FMJ2000/EPR402/README.md

# EPR402
Final year Computer Engineering Project source code repository. Project is to build an autonomous vacuum cleaner.
