FMJ2000/EPR402/body/hendrik.stl

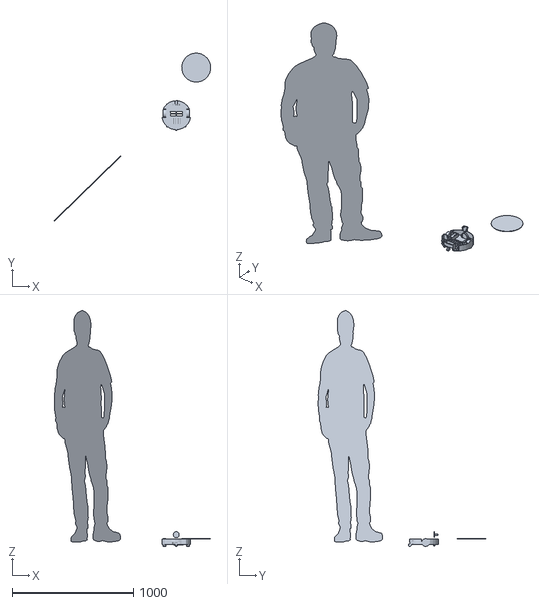
[picture p31: CAD file, 2021-08-24]
body/hendrik.stl
1290.8 x 1384.5 x 1948.0
