FMJ2000/EPR402/Results/Figures/explorer0.png

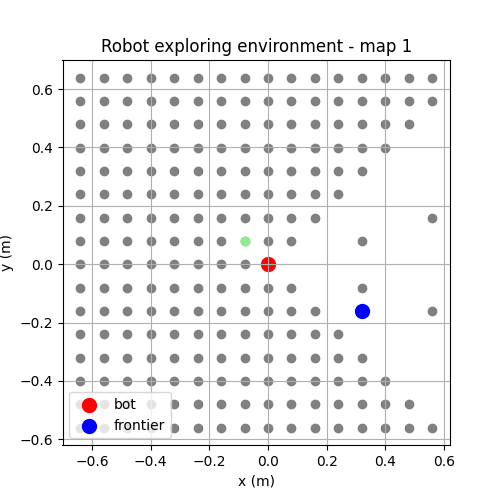
Results/Figures/explorer0.png
