FMJ2000/EPR402/Results/Figures/explorer1.png

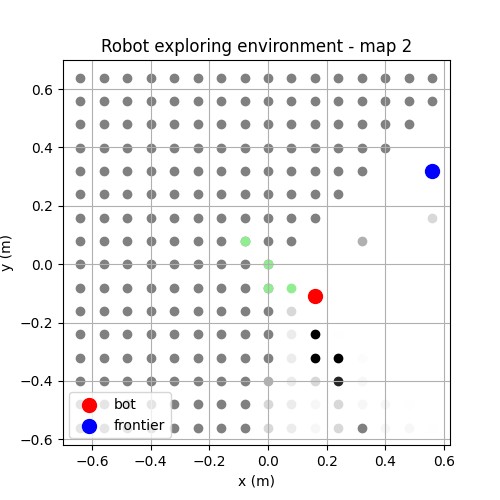
Results/Figures/explorer1.png
