FMJ2000/EPR402/Results/Figures/explorer2.png

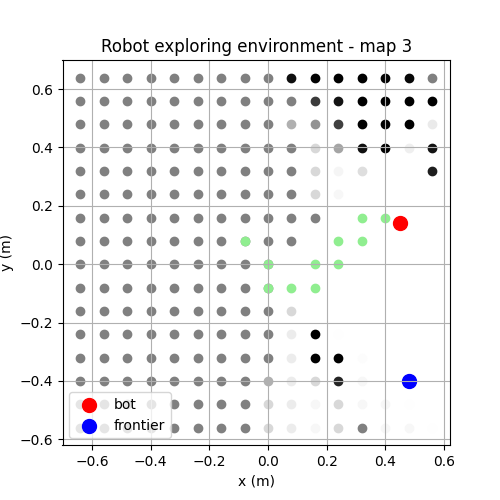
Results/Figures/explorer2.png
