FMJ2000/EPR402/Results/Figures/explorer4.png

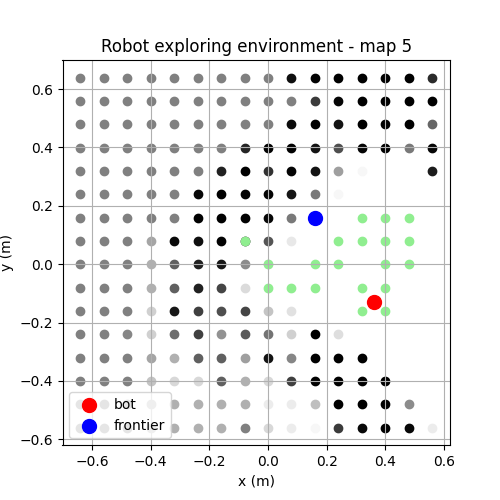
Results/Figures/explorer4.png
