FMJ2000/EPR402/Results/Figures/explorer6.png

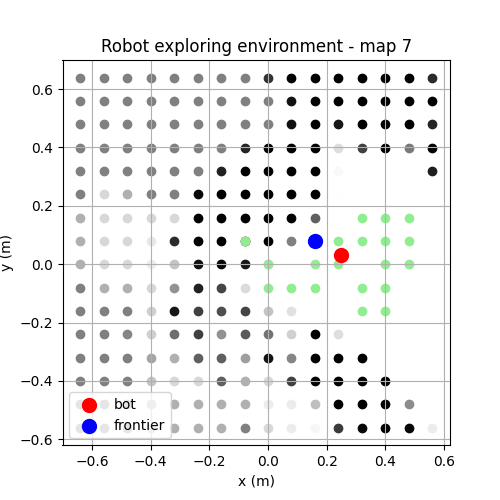
Results/Figures/explorer6.png
