FMJ2000/EPR402/Results/Figures/explorer7.png

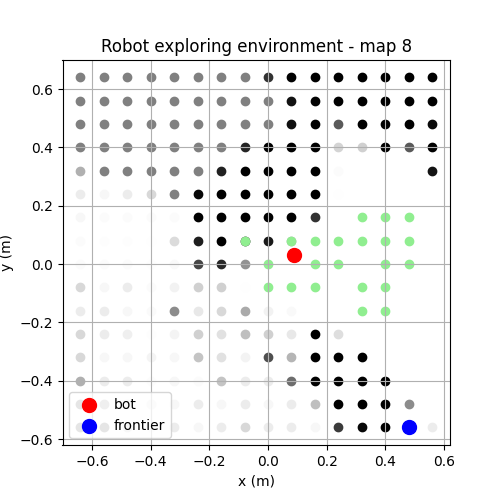
Results/Figures/explorer7.png
