FMJ2000/EPR402/Results/Figures/explorer_full.png

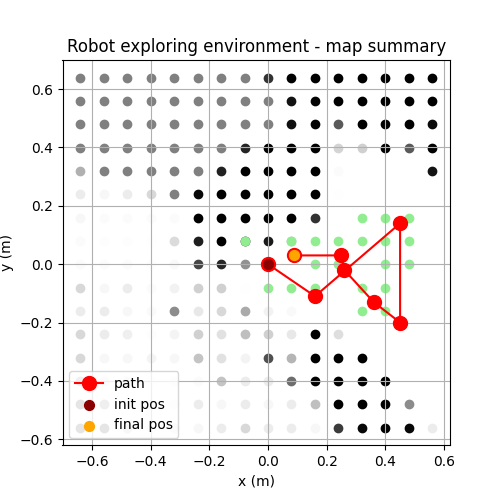
Results/Figures/explorer_full.png
