FMJ2000/EPR402/Results/Figures/planner0.png

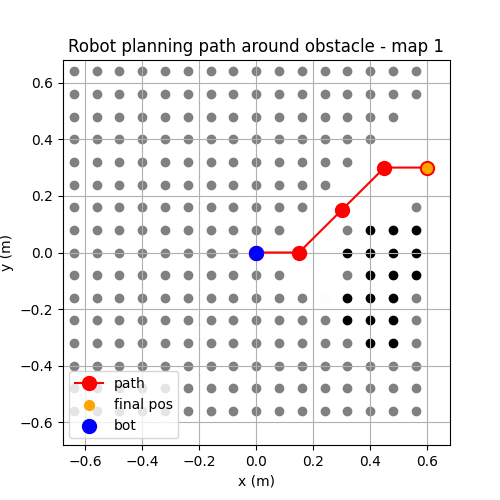
Results/Figures/planner0.png
