FMJ2000/EPR402/Results/Figures/planner3.png

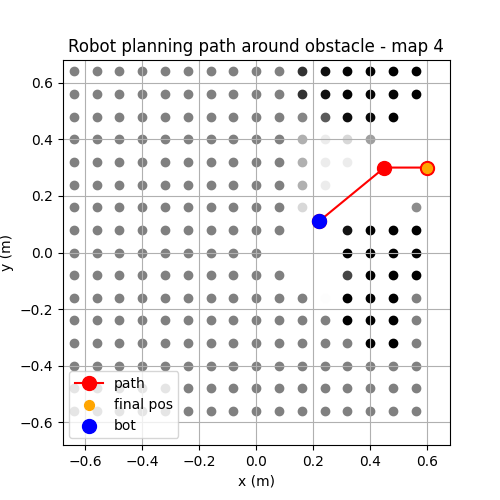
Results/Figures/planner3.png
