FMJ2000/EPR402/Results/Figures/planner5.png

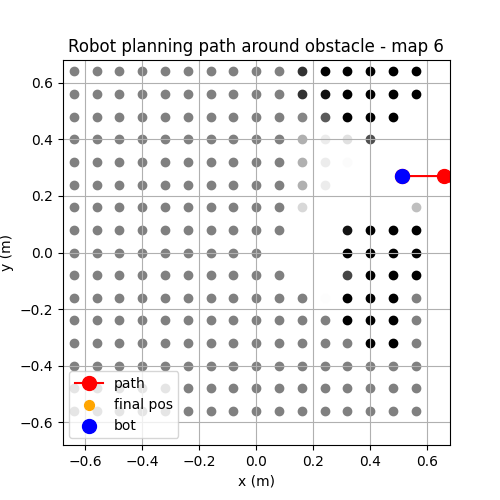
Results/Figures/planner5.png
