FMJ2000/EPR402/Results/Figures/planner8.png

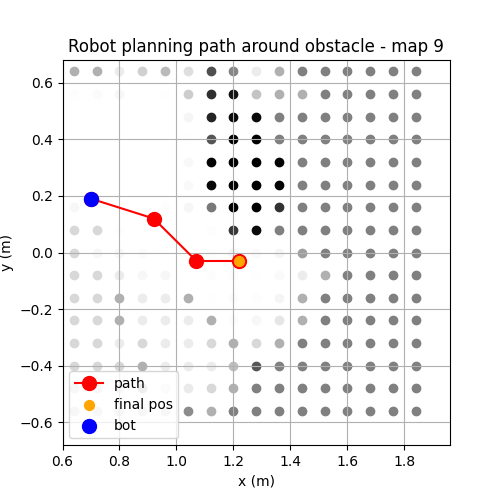
Results/Figures/planner8.png
