FMJ2000/EPR402/Results/Figures/planner9.png

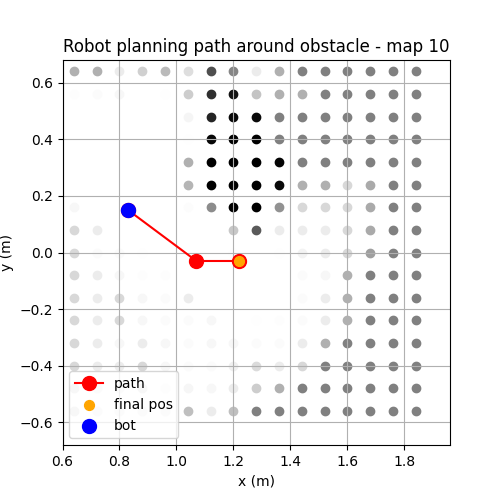
Results/Figures/planner9.png
