FMJ2000/EPR402/Results/Figures/planner10.png

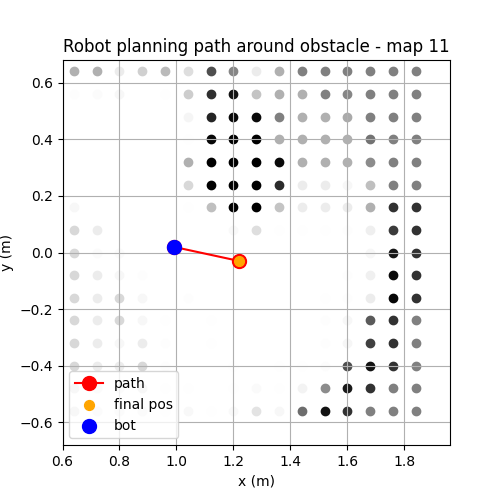
Results/Figures/planner10.png
