FMJ2000/EPR402/Results/Figures/planner11.png

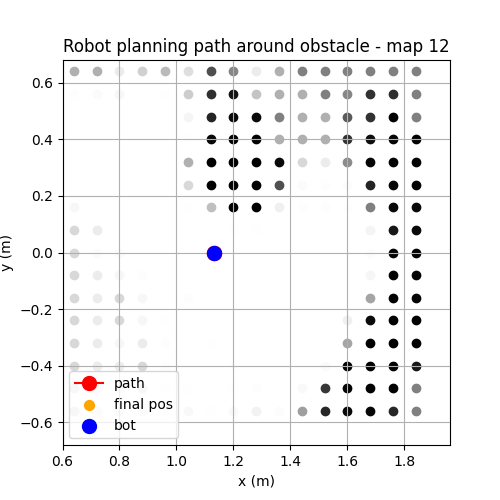
Results/Figures/planner11.png
