FMJ2000/EPR402/Results/Figures/planner_full.png

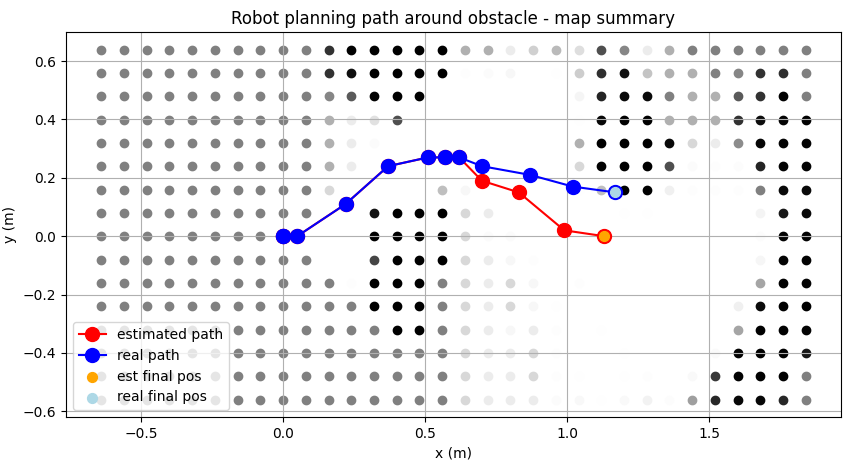
Results/Figures/planner_full.png
