FMJ2000/EPR402/(list of files, drawings)

Other design files:
pcb/hendrik/print.dsn
