FMJ2000/EPR402/pcb/hendrik/hendrik.kicad_pcb

## KiCad design pcb/hendrik/hendrik.kicad_pcb (2021-09-24)

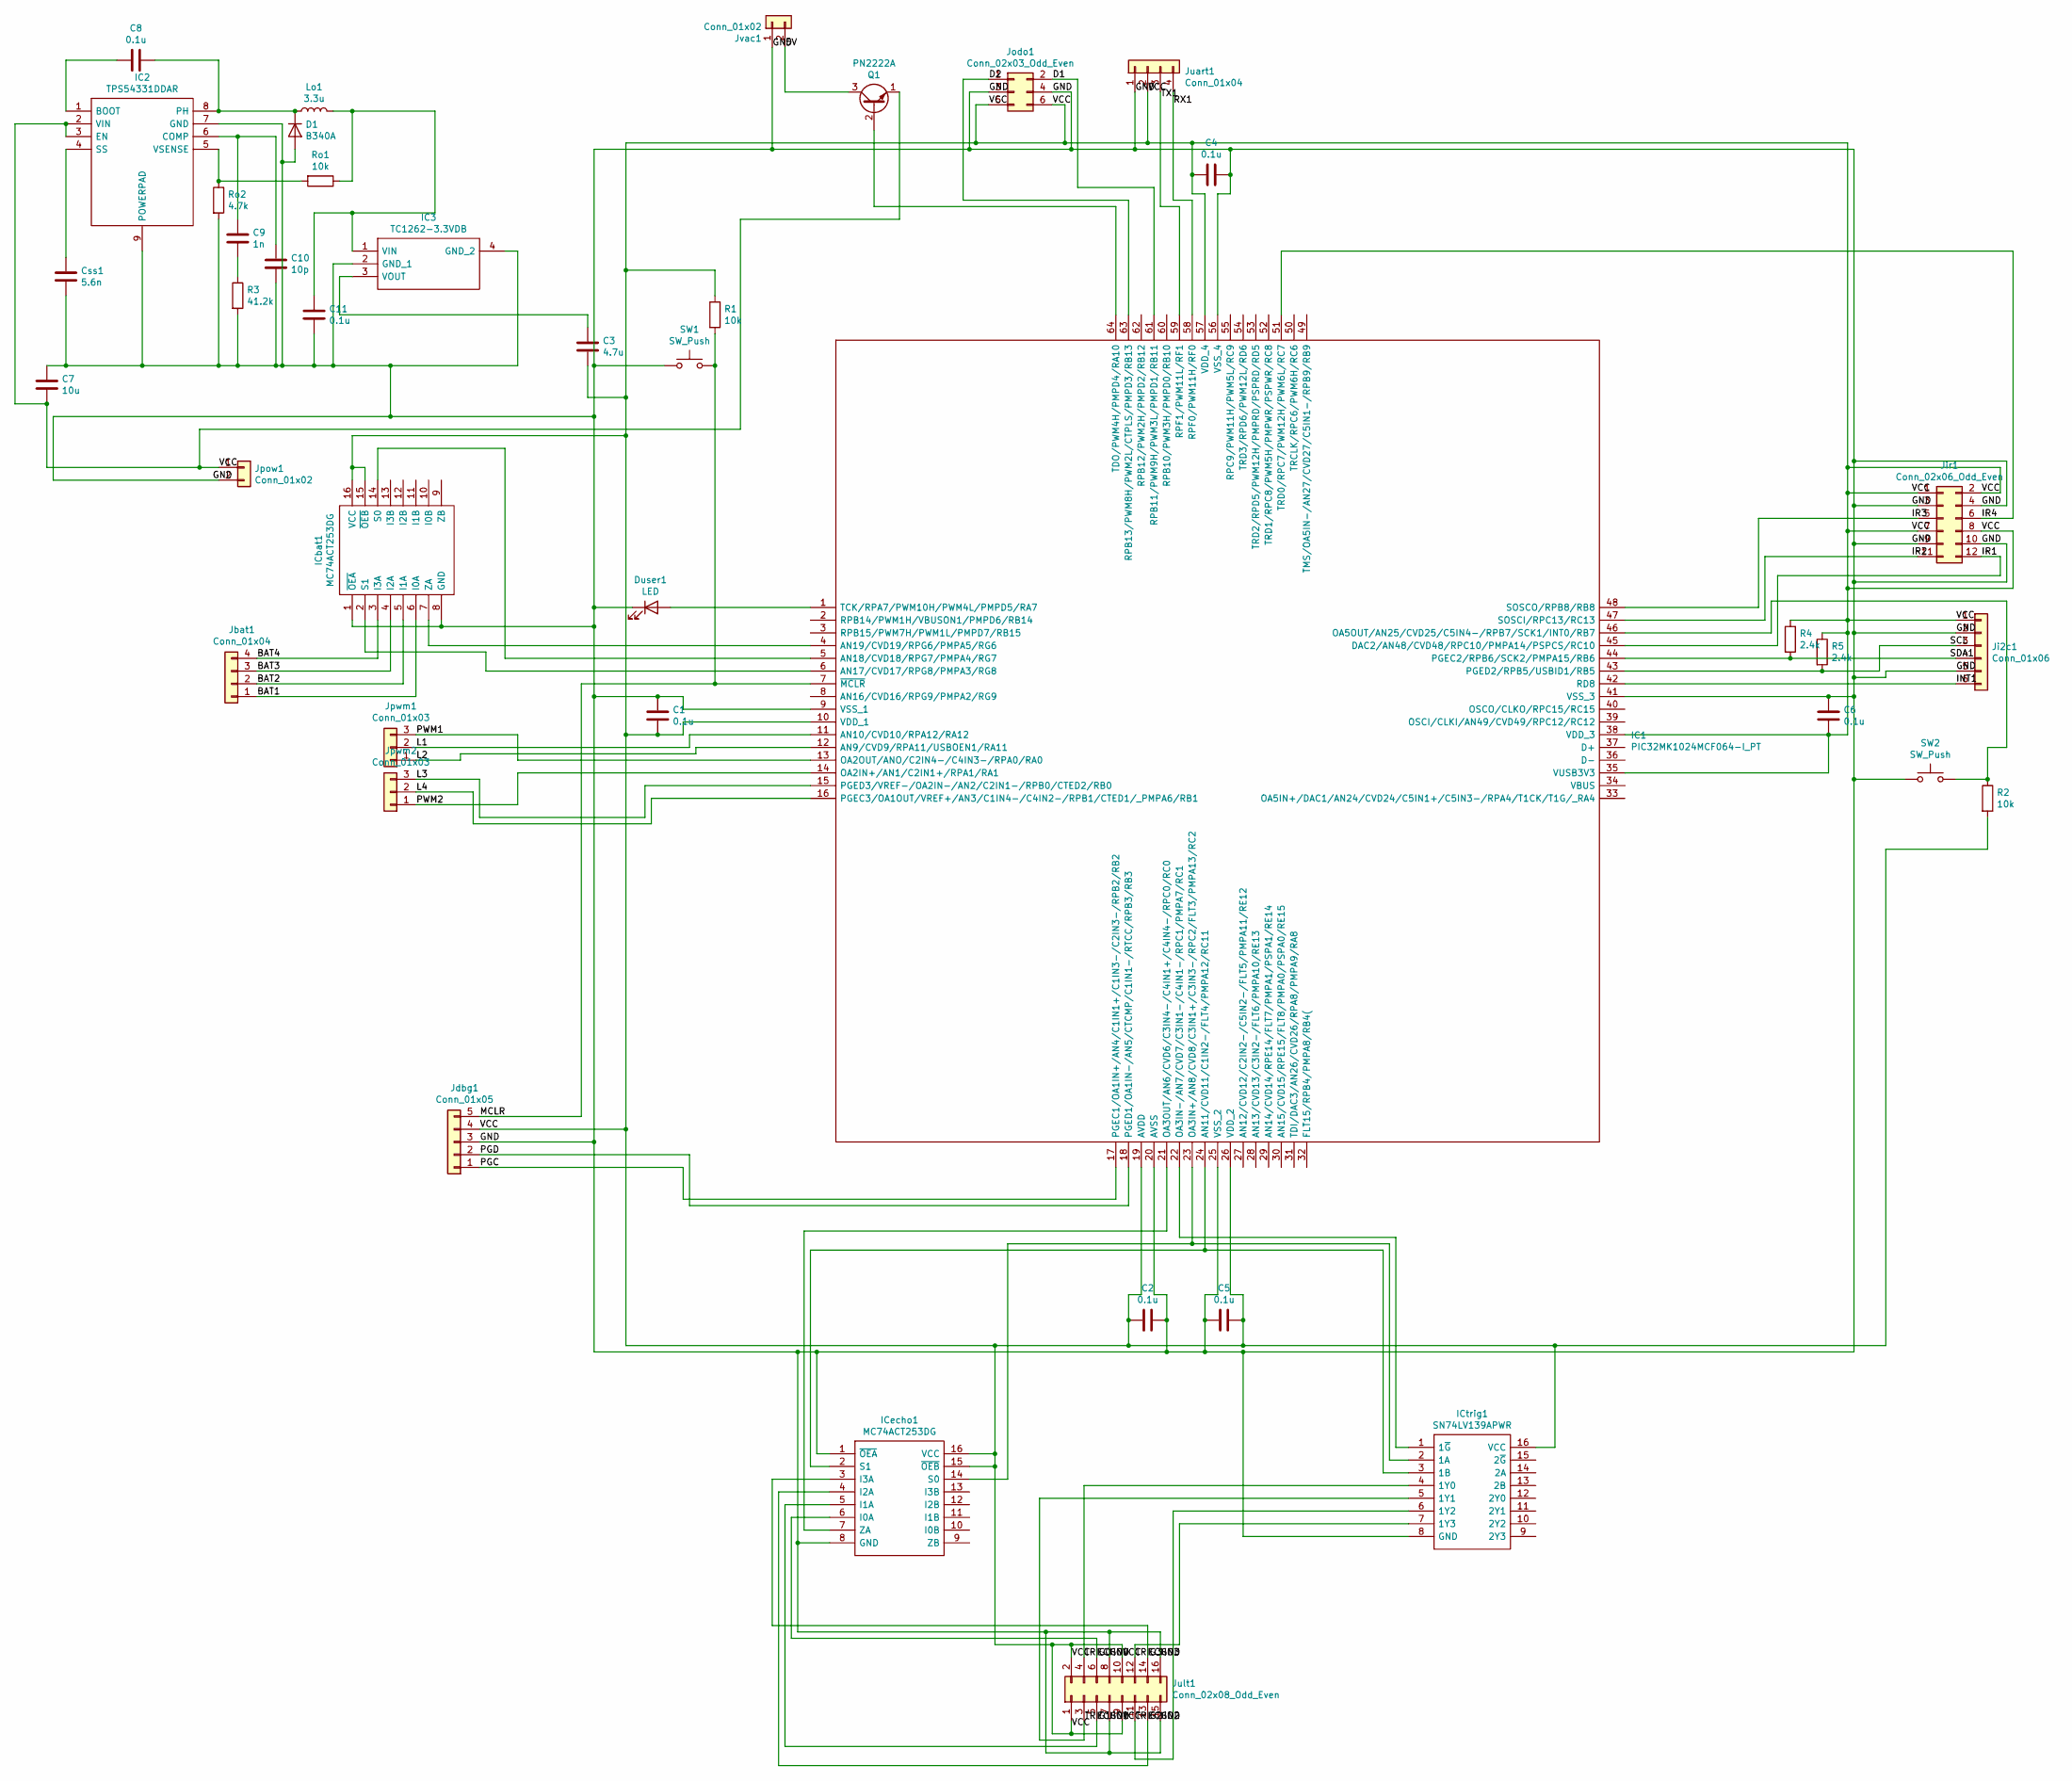
[picture p47: schematic hendrik.sch]

Parts:
C1, C2, C4, C5, C6, C8, C11: 0.1u; C_1206_3216Metric
C3: 4.7u; C_1206_3216Metric
C7: 10u; C_1206_3216Metric
C9: 1n; C_1206_3216Metric
C10: 10p; C_1206_3216Metric
Css1: 5.6n; C_1206_3216Metric
D1: B340A; D_SOD-123
Duser1: LED; LED_1206_3216Metric
IC1: PIC32MK1024MCF064-I_PT; TQFP-64_10x10mm_P0.5mm; Manufacturer_Part_Number PIC32MK1024MCF064-I/PT; Mouser Part Number 579-2MK1024MCF064IPT
IC2: TPS54331DDAR; TI_SO-PowerPAD-8; Manufacturer_Part_Number TPS54331DDAR; Mouser Part Number 595-TPS54331DDAR
IC3: TC1262-3.3VDB; SOT-223; Manufacturer_Part_Number TC1262-3.3VDB; Mouser Part Number 579-TC1262-3.3VDB
ICbat1: MC74ACT253DG; SOIC-16_3.9x9.9mm_P1.27mm; Manufacturer_Part_Number MC74ACT253DG
ICecho1: MC74ACT253DG; SOIC-16_3.9x9.9mm_P1.27mm; Manufacturer_Part_Number MC74ACT253DG
ICtrig1: SN74LV139APWR; TSSOP-16_4.4x5mm_P0.65mm; Manufacturer_Part_Number SN74LV139APWR; Mouser Part Number 595-SN74LV139APWR
Jbat1: Conn_01x04; PinHeader_1x04_P2.54mm_Vertical
Jdbg1: Conn_01x05; PinHeader_1x05_P2.54mm_Vertical
Ji2c1: Conn_01x06; PinHeader_1x06_P2.54mm_Vertical
Jir1: Conn_02x06_Odd_Even; PinHeader_2x06_P2.54mm_Vertical
Jodo1: Conn_02x03_Odd_Even; PinHeader_2x03_P2.54mm_Vertical
Jpow1: Conn_01x02; PinHeader_1x02_P2.54mm_Vertical
Jpwm1, Jpwm2: Conn_01x03; PinHeader_1x03_P2.54mm_Vertical
Juart1: Conn_01x04; PinHeader_1x04_P2.54mm_Vertical
Jult1: Conn_02x08_Odd_Even; PinHeader_2x08_P2.54mm_Vertical
Jvac1: Conn_01x02; PinHeader_1x02_P2.54mm_Vertical
Lo1: 3.3u; L_1210_3225Metric
Q1: PN2222A; TO-92_Inline
R1, R2: 10k; R_1206_3216Metric
R3: 41.2k; R_1206_3216Metric
R4, R5: 2.4k; R_1206_3216Metric
Ro1: 10k; R_1206_3216Metric
Ro2: 4.7k; R_1206_3216Metric
SW1, SW2: SW_Push; SW_PUSH_6mm

Connections:
/5V: Jvac1.2, Q1.3 (C)
/BAT1: ICbat1.6 (I0A), Jbat1.1
/BAT2: ICbat1.5 (I1A), Jbat1.2
/BAT3: ICbat1.4 (I2A), Jbat1.3
/BAT4: ICbat1.3 (I3A), Jbat1.4
/D1: IC1.61 (RPB11/PWM9H/PWM3L/PMPD1/RB11), Jodo1.2
/D2: IC1.63 (RPB13/PWM8H/PWM2L/CTPLS/PMPD3/RB13), Jodo1.1
/ECHO0: ICecho1.6 (I0A), Jult1.6
/ECHO1: ICecho1.5 (I1A), Jult1.5
/ECHO2: ICecho1.4 (I2A), Jult1.13
/ECHO3: ICecho1.3 (I3A), Jult1.14
/GND: C1.1, C2.1, C4.1, C5.2, C6.1, C7.1, C10.2, C11.2, Css1.2, D1.2 (A), Duser1.1 (K), IC1.9 (VSS_1), IC1.20 (AVSS), IC1.25 (VSS_2), IC1.41 (VSS_3), IC1.56 (VSS_4), IC2.7 (GND), IC2.9 (POWERPAD), IC3.2 (GND_1), IC3.4 (GND_2), ICbat1.1 (~OEA), ICbat1.8 (GND), ICecho1.1 (~OEA), ICecho1.8 (GND), ICtrig1.8 (GND), Jdbg1.3, Ji2c1.2, Ji2c1.5, Jir1.3, Jir1.4, Jir1.9, Jir1.10, Jodo1.3, Jodo1.4, Jpow1.2, Juart1.1, Jult1.7, Jult1.8, Jult1.15, Jult1.16, Jvac1.1, R3.2, Ro2.2, SW1.1, SW2.1; also elsewhere on the board
/INT1: IC1.42 (RD8), Ji2c1.6
/IR1: IC1.45 (DAC2/AN48/CVD48/RPC10/PMPA14/PSPCS/RC10), Jir1.12
/IR2: IC1.47 (SOSCI/RPC13/RC13), Jir1.11
/IR3: IC1.48 (SOSCO/RPB8/RB8), Jir1.5
/IR4: IC1.51 (TRD0/RPC7/PWM12H/PWM6L/RC7), Jir1.6
/L1: IC1.11 (AN10/CVD10/RPA12/RA12), Jpwm1.2
/L2: IC1.12 (AN9/CVD9/RPA11/USBOEN1/RA11), Jpwm1.1
/L3: IC1.15 (PGED3/VREF-/OA2IN-/AN2/C2IN1-/RPB0/CTED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), Jpwm2.3
/L4: IC1.16 (PGEC3/OA1OUT/VREF+/AN3/C1IN4-/C4IN2-/RP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), Jpwm2.2
/MCLR: IC1.7 (~MCLR), Jdbg1.5, R1.2, SW1.2; also elsewhere on the board
/PGC: IC1.17 (PGEC1/OA1IN+/AN4/C1IN1+/C1IN3-/C2IN3-/R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), Jdbg1.1
/PGD: IC1.18 (PGED1/OA1IN-/AN5/CTCMP/C1IN1-/RTCC/RPB3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), Jdbg1.2
/PWM1: IC1.13 (OA2OUT/ANO/C2IN4-/C4IN3-/RPA0/RA0), Jpwm1.3
/PWM2: IC1.14 (OA2IN+/AN1/C2IN1+/RPA1/RA1), Jpwm2.1
/RX1: IC1.58 (RPF0/PWM11H/RF0), Juart1.4
/SCL: IC1.43 (PGED2/RPB5/USBID1/RB5), Ji2c1.3, R5.2
/SDA1: IC1.44 (PGEC2/RPB6/SCK2/PMPA15/RB6), Ji2c1.4, R4.2
/TRIG0: ICtrig1.4 (1Y0), Jult1.4
/TRIG1: ICtrig1.5 (1Y1), Jult1.3
/TRIG2: ICtrig1.6 (1Y2), Jult1.11
/TRIG3: ICtrig1.7 (1Y3), Jult1.12
/TX1: IC1.59 (RPF1/PWM11L/RF1), Juart1.3
/VCC: C1.2, C2.2, C3.2, C4.2, C5.1, C6.2, C7.2, IC1.10 (VDD_1), IC1.19 (AVDD), IC1.26 (VDD_2), IC1.35 (VUSB3V3), IC1.38 (VDD_3), IC1.57 (VDD_4), IC2.2 (VIN), IC2.3 (EN), ICbat1.15 (~OEB), ICbat1.16 (VCC), ICecho1.15 (~OEB), ICecho1.16 (VCC), ICtrig1.16 (VCC), Jdbg1.4, Ji2c1.1, Jir1.1, Jir1.2, Jir1.7, Jir1.8, Jodo1.5, Jodo1.6, Jpow1.1, Juart1.2, Jult1.1, Jult1.2, Jult1.9, Jult1.10, Q1.1 (E), R1.1, R2.2, R4.1, R5.1
unnamed: C3.1, IC3.3 (VOUT)
unnamed: C8.1, D1.1 (K), IC2.8 (PH), Lo1.1
unnamed: C8.2, IC2.1 (BOOT)
unnamed: C9.2, R3.1
unnamed: C9.1, C10.1, IC2.6 (COMP)
unnamed: C11.1, IC3.1 (VIN), Lo1.2, Ro1.1
unnamed: Css1.1, IC2.4 (SS)
unnamed 42: Duser1.2 (A), IC1.1 (TCK/RPA7/PWM10H/PWM4L/PMPD5/RA7); also elsewhere on the board
unnamed: IC1.4 (AN19/CVD19/RPG6/PMPA5/RG6), ICbat1.7 (ZA)
unnamed: IC1.5 (AN18/CVD18/RPG7/PMPA4/RG7), ICbat1.14 (S0)
unnamed: IC1.6 (AN17/CVD17/RPG8/PMPA3/RG8), ICbat1.2 (S1)
unnamed: IC1.21 (OA3OUT/AN6/CVD6/C3IN4-/C4IN1+/C4IN4-/RP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), ICecho1.7 (ZA)
unnamed: IC1.22 (OA3IN-/AN7/CVD7/C3IN1-/C4IN1-/RPC1/PMPA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), ICtrig1.1 (1~G)
unnamed: IC1.23 (OA3IN+/AN8/CVD8/C3IN1+/C3IN3-/RPC2/FLT3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), ICecho1.14 (S0), ICtrig1.2 (1A)
unnamed: IC1.24 (AN11/CVD11/C1IN2-/FLT4/PMPA12/RC11), ICecho1.2 (S1), ICtrig1.3 (1B)
unnamed 65: IC1.46 (OA5OUT/AN25/CVD25/C5IN4-/RPB7/SCK1/INT0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), R2.1, SW2.2; also elsewhere on the board
unnamed: IC1.64 (TDO/PWM4H/PMPD4/RA10), Q1.2 (B)
unnamed: IC2.5 (VSENSE), Ro1.2, Ro2.1

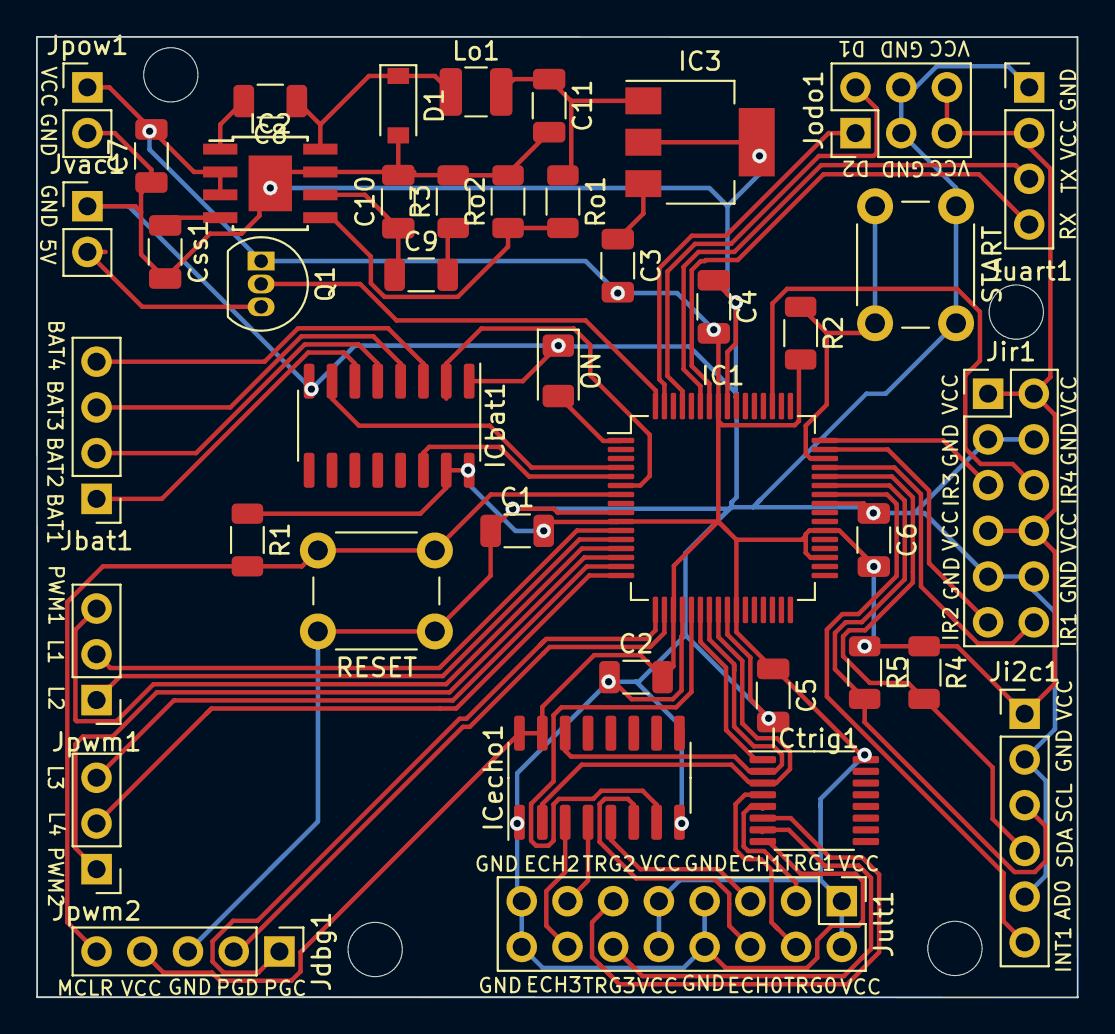
[picture p48: board hendrik.kicad_pcb from above]

Board: 2 copper layers, 57.8 x 53.4 mm, 42 parts (0 on the bottom side), 53 nets.

Other parts of the board:
ON: LED; LED_1206_3216Metric
RESET: SW_Push; SW_PUSH_6mm
START: SW_Push; SW_PUSH_6mm

Their connections:
/GND: ON.1, RESET.1, START.1; also elsewhere on the board
/MCLR: RESET.2; also elsewhere on the board
unnamed 42: ON.2; also elsewhere on the board
unnamed 65: START.2; also elsewhere on the board
