FMJ2000/EPR402/ultrasonic/hcsr04_tut/hcsr04_tut.ino

#define echoPin1 2
#define trigPin1 3
#define echoPin2 4
#define trigPin2 5

long duration1, duration2;
float distance1, distance2;

void setup() {
  pinMode(trigPin1, OUTPUT);
  pinMode(trigPin2, OUTPUT);
  pinMode(echoPin1, INPUT);
  pinMode(echoPin2, INPUT);
  Serial.begin(9600);
  Serial.println("Ultrasonic Sensor HC-SR04 Test");
  Serial.println("with Arduino UNO");
}

void loop() {
  // sensor 1
  digitalWrite(trigPin1, LOW);
  delayMicroseconds(2);
  digitalWrite(trigPin1,HIGH);
  delayMicroseconds(10);
  digitalWrite(trigPin1, LOW);
  duration1 = pulseIn(echoPin1, HIGH);
  distance1 = duration1 * 0.034 / 2;

  // sensor 2
  digitalWrite(trigPin2, LOW);
  delayMicroseconds(2);
  digitalWrite(trigPin2,HIGH);
  delayMicroseconds(10);
  digitalWrite(trigPin2, LOW);
  duration2 = pulseIn(echoPin2, HIGH);
  distance2 = duration2 * 0.034 / 2;
  
  Serial.print("distance 1: ");
  Serial.print(distance1);
  Serial.print(" cm\tdistance 2: ");
  Serial.print(distance2);
  Serial.println(" cm");
  delay(500);
}
