FMJ2000/EPR402/mplab/Master.X/oled.c

/*
 * @file OLED.c
 * @author xpress_embedo
 * @date 2 Feb, 2020
 * 
 * @brief This file contains OLED drivers for SSD1306 Controller
 *
 */

#include "oled.h"

// Constant Fonts
const uint8_t SMALL_FONTS[] =
{
0x06, 0x08, 0x20, 0x5f,               // x_size, y_size, offset, number of char
0x00, 0x00, 0x00, 0x00, 0x00, 0x00,   // sp
0x00, 0x00, 0x00, 0x2f, 0x00, 0x00,   // !
0x00, 0x00, 0x07, 0x00, 0x07, 0x00,   // "
0x00, 0x14, 0x7f, 0x14, 0x7f, 0x14,   // #
0x00, 0x24, 0x2a, 0x7f, 0x2a, 0x12,   // $
0x00, 0x23, 0x13, 0x08, 0x64, 0x62,   // %
0x00, 0x36, 0x49, 0x55, 0x22, 0x50,   // &
0x00, 0x00, 0x05, 0x03, 0x00, 0x00,   // '
0x00, 0x00, 0x1c, 0x22, 0x41, 0x00,   // (
0x00, 0x00, 0x41, 0x22, 0x1c, 0x00,   // )
0x00, 0x14, 0x08, 0x3E, 0x08, 0x14,   // *
0x00, 0x08, 0x08, 0x3E, 0x08, 0x08,   // +
0x00, 0x00, 0x00, 0xA0, 0x60, 0x00,   // ,
0x00, 0x08, 0x08, 0x08, 0x08, 0x08,   // -
0x00, 0x00, 0x60, 0x60, 0x00, 0x00,   // .
0x00, 0x20, 0x10, 0x08, 0x04, 0x02,   // /

0x00, 0x3E, 0x51, 0x49, 0x45, 0x3E,   // 0
0x00, 0x00, 0x42, 0x7F, 0x40, 0x00,   // 1
0x00, 0x42, 0x61, 0x51, 0x49, 0x46,   // 2
0x00, 0x21, 0x41, 0x45, 0x4B, 0x31,   // 3
0x00, 0x18, 0x14, 0x12, 0x7F, 0x10,   // 4
0x00, 0x27, 0x45, 0x45, 0x45, 0x39,   // 5
0x00, 0x3C, 0x4A, 0x49, 0x49, 0x30,   // 6
0x00, 0x01, 0x71, 0x09, 0x05, 0x03,   // 7
0x00, 0x36, 0x49, 0x49, 0x49, 0x36,   // 8
0x00, 0x06, 0x49, 0x49, 0x29, 0x1E,   // 9
0x00, 0x00, 0x36, 0x36, 0x00, 0x00,   // :
0x00, 0x00, 0x56, 0x36, 0x00, 0x00,   // ;
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
0x01,0x01,0x01,0x01,0x00,0x00,0x00,0x00,0x01,0x01,0x01,0x01,0x01,0x00,0x00,0x00,
0x00,0x00,0x01,0x01,0x01,0x00,0x00,0x00,0x00,0x00,0x00,0x00,0x18,0x1D,0x1F,0x0F,
0x03,0x00,0x00,0x00,0x00,0x00,0x00,0x00,0x00,0x00,0x00,0x00,0x00,0x00,0x00,0x00,

0x00,0x00,0x00,0x00,0x00,0x00,0x00,0x00,0x00,0x00,0x00,0x00,0x00,0x00,0x00,0x00,
0x00,0x00,0x00,0x00,0x00,0x00,0x00,0x00,0x00,0x00,0x00,0x00,0x00,0x00,0x00,0x00,
0x00,0x00,0x00,0x00,0x00,0x00,0x00,0x00,0x00,0x00,0x00,0x00,0x00,0x00,0x00,0x00,
0x00,0x00,0x00,0x00,0x00,0x00,0x00,0x00,0x00,0x00,0x00,0x00,0x00,0x00,0x00,0x00,
0x00,0x00,0x00,0x00,0x00,0x00,0x00,0x00,0x00,0x00,0x00,0x00,0x00,0x00,0x00,0x00,
0x00,0x00,0x00,0x00,0x00,0x00,0x00,0x00,0x00,0x00,0x00,0x00,0x00,0x00,0x00,0x00,
0x00,0x00,0x00,0x00,0x00,0x00,0x00,0x00,0x00,0x00,0x00,0x00,0x00,0x00,0x00,0x00,
0x00,0x00,0x00,0x00,0x00,0x00,0x00,0x00,0x00,0x00,0x00,0x00,0x00,0x00,0x00,0x00
#endif
#endif
};

/* Local Function Prototypes */
static uint8_t width( void );
static uint8_t height( void );
static void swap_num( uint16_t *a, uint16_t *b );

/* Public Function Definition */

/**
 * @brief OLED_Init
 *
 * Initialize OLED
 */
void OLED_Init( void )
{
    I2C_Write(SSD1306_ADDR, 0x00, SSD1306_DISPLAY_OFF);
    I2C_Write(SSD1306_ADDR, 0x00, SSD1306_SET_DISPLAY_CLOCK_DIV_RATIO);
    I2C_Write(SSD1306_ADDR, 0x00, 0x80);
    I2C_Write(SSD1306_ADDR, 0x00, SSD1306_SET_MULTIPLEX_RATIO);
    I2C_Write(SSD1306_ADDR, 0x00, SSD1306_LCDHEIGHT - 1);
    I2C_Write(SSD1306_ADDR, 0x00, SSD1306_SET_DISPLAY_OFFSET);
    I2C_Write(SSD1306_ADDR, 0x00, 0x00);
    I2C_Write(SSD1306_ADDR, 0x00, SSD1306_SET_START_LINE|0x0);
    I2C_Write(SSD1306_ADDR, 0x00, SSD1306_CHARGE_PUMP);
    I2C_Write(SSD1306_ADDR, 0x00, 0x14);
    I2C_Write(SSD1306_ADDR, 0x00, SSD1306_MEMORY_ADDR_MODE);
    I2C_Write(SSD1306_ADDR, 0x00, 0x00);
    I2C_Write(SSD1306_ADDR, 0x00, SSD1306_SET_SEGMENT_REMAP|0x01);
    I2C_Write(SSD1306_ADDR, 0x00, SSD1306_COM_SCAN_DIR_DEC);
#ifdef SSD1306_128_32
    I2C_Write(SSD1306_ADDR, 0x00, SSD1306_SET_COM_PINS);
    I2C_Write(SSD1306_ADDR, 0x00, 0x02);
    I2C_Write(SSD1306_ADDR, 0x00, SSD1306_SET_CONTRAST_CONTROL);
    I2C_Write(SSD1306_ADDR, 0x00, 0x8F);
#elif defined SSD1306_128_64 
    I2C_Write(SSD1306_ADDR, 0x00, SSD1306_SET_COM_PINS);
    I2C_Write(SSD1306_ADDR, 0x00, 0x12);
    I2C_Write(SSD1306_ADDR, 0x00, SSD1306_SET_CONTRAST_CONTROL);
    I2C_Write(SSD1306_ADDR, 0x00, 0xCF);
#endif
    I2C_Write(SSD1306_ADDR, 0x00, SSD1306_SET_PRECHARGE_PERIOD);
    I2C_Write(SSD1306_ADDR, 0x00, 0xF1);
    I2C_Write(SSD1306_ADDR, 0x00, SSD1306_SET_VCOM_DESELECT);
    I2C_Write(SSD1306_ADDR, 0x00, 0x40);
    I2C_Write(SSD1306_ADDR, 0x00, SSD1306_DISPLAY_ALL_ON_RESUME);
    I2C_Write(SSD1306_ADDR, 0x00, SSD1306_NORMAL_DISPLAY);
    I2C_Write(SSD1306_ADDR, 0x00, SSD1306_DEACTIVATE_SCROLL);
    I2C_Write(SSD1306_ADDR, 0x00, SSD1306_DISPLAY_ON);
    OLED_SetFont(SMALL_FONTS);
    delay(100000);
    OLED_Update();
}

/**
 * @brief OLED_Width
 *
 * Get the OLED Width
 * @return Oled Width
 */
uint8_t OLED_Width( void )
{
  return width();
}

/**
 * @brief OLED_Height
 *
 * Get the OLED Height
 * @return Oled Height
 */
uint8_t OLED_Height( void )
{
  return height();
}

/**
 * @brief OLED_SetFont
 *
 * @param font: Select this font
 */
void OLED_SetFont( const uint8_t *font)
{
  cfont.font = font;
  cfont.x_size = *(font+0);
  cfont.y_size = *(font+1);
  cfont.offset  = *(font+2);
  cfont.numchars  = *(font+3);
  cfont.inverted = FALSE;
}

/**
 * @brief OLED_InvertFont
 *
 * Invert the font
 */
void OLED_InvertFont( uint8_t invert_status )
{
  if( invert_status )
  {
    cfont.inverted = TRUE;
  }
  else
  {
    cfont.inverted = FALSE;
  }
}

/**
 * @brief OLED_Update
 *
 * Update the OLED Buffer on the actual display
 */
void OLED_Update( void )
{
    I2C_Write(SSD1306_ADDR, 0x00, SSD1306_SET_COLUMN_ADDR);
    I2C_Write(SSD1306_ADDR, 0x00, 0x0);
    I2C_Write(SSD1306_ADDR, 0x00, SSD1306_LCDWIDTH-1);
    I2C_Write(SSD1306_ADDR, 0x00, SSD1306_SET_PAGE_ADDR);
    I2C_Write(SSD1306_ADDR, 0x00, 0x0);
 #if SSD1306_LCDHEIGHT == 64
    I2C_Write(SSD1306_ADDR, 0x00, 0x7);// Page end address
  #endif
  #if SSD1306_LCDHEIGHT == 32
    I2C_Write(SSD1306_ADDR, 0x00, 0x3); // Page end address
  #endif
  #if SSD1306_LCDHEIGHT == 16
    I2C_Write(SSD1306_ADDR, 0x00, 0x1); // Page end address
  #endif

    
    I2C_Master_Start();
    I2C_Master_Write(SSD1306_ADDR << 1);
    I2C_Master_Write(0x40);
    for (uint16_t i = 0; i < (SSD1306_LCDWIDTH*SSD1306_LCDHEIGHT/8); i++) I2C_Master_Write(buffer[i]);
    I2C_Master_Stop();
}

/**
 * @brief OLED_SetContrast.
 *
 * Set the OLED display contrast.
 * @param contrast: contrast value
 */
void OLED_SetContrast( uint8_t contrast )
{
    I2C_Write(SSD1306_ADDR, 0x00, SSD1306_SET_CONTRAST_CONTROL);
    I2C_Write(SSD1306_ADDR, 0x00, contrast);
}

/**
 * @brief OLED_DrawPixel.
 *
 * Clear the OLED Buffer.
 */
void OLED_ClearDisplay( void )
{
  memset(buffer, 0, (SSD1306_LCDWIDTH*SSD1306_LCDHEIGHT/8));
}

/**
 * @brief OLED_FillDisplay.
 *
 * Fill the OLED Buffer.
 */
void OLED_FillDisplay( void )
{
  memset(buffer, 0xFF, (SSD1306_LCDWIDTH*SSD1306_LCDHEIGHT/8));
}

/**
 * @brief OLED_InvertDisplay.
 *
 * Invert the Display based on the parameters
 * @param value: If True invert the display
 */
void OLED_InvertDisplay( uint8_t value )
{
  if( value ) I2C_Write(SSD1306_ADDR, 0x00, SSD1306_INVERT_DISPLAY);
  else I2C_Write(SSD1306_ADDR, 0x00, SSD1306_NORMAL_DISPLAY);
}

/**
 * @brief OLED_DrawPixel.
 *
 * Draws a pixel on OLED by using the specified parameters.
 * @param x: x coordinate with valid values: 0..127
 * @param y: y coordinate with valid values: 0..63
 * @param color: color parameter. Valid values: 0 and 1
 */
void OLED_DrawPixel( int16_t x, int16_t y, uint8_t color)
{
  if ( (x < 0) || (x >= width()) || (y < 0) || (y >= height()))
    return;

  switch (color)
  {
    case WHITE:   buffer[x+ (y/8)*SSD1306_LCDWIDTH] |=  (1 << (y&7)); break;
    case BLACK:   buffer[x+ (y/8)*SSD1306_LCDWIDTH] &= ~(1 << (y&7)); break;
    case INVERSE: buffer[x+ (y/8)*SSD1306_LCDWIDTH] ^=  (1 << (y&7)); break;
  }
}

/**
 * @brief Draws a line on OLED.
 *
 * Draws a line on OLED by using the specified parameters.
 * <a href="https://en.wikipedia.org/wiki/Bresenham%27s_line_algorithm">
 * Algorithm Used</a>
 * <a href="http://www.edaboard.com/thread68526.html#post302856"> Program Used
 * </a>
 *
 * @param x_start: x coordinate of start point. Valid values: 0..127
 * @param y_start: x coordinate of start point. Valid values: 0..63
 * @param x_end: x coordinate of end point. Valid values: 0..127
 * @param y_end: y coordinate of end point. Valid values: 0..63
 * @param color: color parameter. Valid values: 0 and 1
 */
void OLED_Line( int16_t x_start, int16_t y_start, int16_t x_end, int16_t y_end, uint8_t color)
{
  int16_t x, y, addx, addy, dx, dy;
  int32_t P;
  int16_t i;
  dx = abs((int16_t)(x_end - x_start));
  dy = abs((int16_t)(y_end - y_start));
  x = x_start;
  y = y_start;

  if(x_start > x_end)
    addx = -1;
  else
    addx = 1;

  if(y_start > y_end)
    addy = -1;
  else
    addy = 1;

  if(dx >= dy)
  {
    P = 2*dy - dx;

    for(i=0; i<=dx; ++i)
    {
      OLED_DrawPixel (x,y,color);
      if(P < 0)
      {
        P += 2*dy;
        x += addx;
      }
      else
      {
        P += 2*dy - 2*dx;
        x += addx;
        y += addy;
      }
    }
  }
  else
  {
    P = 2*dx - dy;
    for(i=0; i<=dy; ++i)
    {
      OLED_DrawPixel (x,y,color);

      if(P < 0)
      {
        P += 2*dx;
        y += addy;
      }
      else
      {
        P += 2*dx - 2*dy;
        x += addx;
        y += addy;
      }
    }
  }
}


/**
 * @brief OLED Vertical Line.
 *
 * Draw vertical line between of length specified by y_start and y_end, and at
 * position specified by x_pos
 *
 * @param y_start: y position to start vertical line. Valid values: 0..63
 * @param y_end: y position to end vertical line. Valid values: 0..63
 * @param x_pos: x position. Valid values: 0..127
 * @param color: color parameter. Valid values: 0 and 1
 */
void OLED_V_Line ( int16_t y_start, int16_t y_end, int16_t x_pos, uint8_t color)
{
  int16_t temp;
  if( y_start > y_end )
  {
    temp = y_start;
    y_start = y_end;
    y_end = temp;
  }

  while( y_start <= y_end )
  {
    OLED_DrawPixel(x_pos, y_start, color);
    y_start++;
  }
}

/**
 * @brief OLED Horizontal Line.
 *
 * Draw horizontal line between of length specified by x_start and x_end, and at
 * position specified by y_pos
 *
 * @param x_start: y position to start horizontal line. Valid values: 0..127
 * @param x_end: y position to end horizontal line. Valid values: 0..127
 * @param y_pos: x position. Valid values: 0..63
 * @param color: color parameter. Valid values: 0 and 1
 */
void OLED_H_Line( int16_t x_start, int16_t x_end, int16_t y_pos, uint8_t color)
{
  int16_t temp;
  if( x_start > x_end )
  {
    temp = x_start;
    x_start = x_end;
    x_end = temp;
  }

  while( x_start <= x_end )
  {
    OLED_DrawPixel(x_start, y_pos, color);
    x_start++;
  }
}

/**
 * @brief Draws a rectangle on OLED.
 *
 * Draws a rectangle on OLED by using the specified parameters.
 *
 * @param x1: x coordinate of the upper left rectangle corner.
 * Valid values: 0..127
 * @param y1: y coordinate of the upper left rectangle corner.
 * Valid values: 0..63
 * @param x2: x coordinate of the lower right rectangle corner.
 * Valid values: 0..127
 * @param y2: y coordinate of the lower right rectangle corner.
 * Valid values: 0..63
 * @param color: color parameter. Valid values: 0 and 1
 */
void OLED_Rectangle( int16_t x1, int16_t y1, int16_t x2, int16_t y2, uint8_t color)
{
  /*
  x1,y1 Upper Left
  y1,y2 Bottom Right
  */
  OLED_H_Line(x1, x2, y1, color);
  OLED_H_Line(x1, x2, y2, color);
  OLED_V_Line(y1, y2, x1, color);
  OLED_V_Line(y1, y2, x2, color);
}

/**
 * @brief OLED_FillRectangle
 *
 * Draws a rectangle on OLED by using the specified parameters with filling.
 *
 * @param x1: x coordinate of the upper left rectangle corner. Valid values: 0..127
 * @param y1: y coordinate of the upper left rectangle corner. Valid values: 0..63
 * @param x2: x coordinate of the lower right rectangle corner. Valid values: 0..127
 * @param y2: y coordinate of the lower right rectangle corner. Valid values: 0..63
 * @param color: color parameter. Valid values: 0 and 1
 */
void OLED_FillRectangle( int16_t x1, int16_t y1, int16_t x2, int16_t y2, uint8_t color)
{
  int16_t i;
  for( i=x1; i<=x2; i++ )
  {
    OLED_V_Line(y1, y2, i, color );
  }
}

/**
 * @brief OLED_Triangle
 *
 * Draw a Triangle based on the coordinates
 *
 * @param x0: x0 coordinate
 * @param y0: y0 coordinate
 * @param x1: x1 coordinate
 * @param y1: y1 coordinate
 * @param x2: x2 coordinate
 * @param y2: y2 coordinate
 * @param color: color parameter. Valid values: 0 and 1
 */
void OLED_Triangle( int16_t x0, int16_t y0, int16_t x1, int16_t y1, int16_t x2, int16_t y2, uint8_t color)
{
  OLED_Line(x0, y0, x1, y1, color);
  OLED_Line(x1, y1, x2, y2, color);
  OLED_Line(x2, y2, x0, y0, color);
}

/**
 * @brief OLED Image.
 *
 * Displays bitmap image on OLED.
 *
 * @param *image: image to be displayed. Bitmap array must be located in code
 * memory. Use the mikroC PRO for PIC integrated Glcd Bitmap Editor to convert
 * image to a constant array suitable for displaying on Glcd.
 */
void OLED_Image( const uint8_t *image)
{
  uint16_t i;
  for( i=0; i<(SSD1306_LCDWIDTH*SSD1306_LCDHEIGHT/8); i++)
  {
    buffer[i] = *(image+i);
  }
}

/**
 * @brief Draws a Circle on OLED.
 *
 * Draws a Circle on OLED by using the specified parameters.
 * <a href="https://en.wikipedia.org/wiki/Midpoint_circle_algorithm">
 * Mid Point Circle Algorithm Weblink</a>
 *
 * @param x_center: x coordinate of the circle center. Valid values: 0..127
 * @param y_center: y coordinate of the circle center. Valid values: 0..63
 * @param radius: radius of the circle.
 * @param color: color parameter. Valid values: 0 and 1
 */
void OLED_Circle( int16_t x0, int16_t y0, int16_t r, uint8_t color )
{
  int16_t f = 1 - r;
  int16_t ddF_x = 1;
  int16_t ddF_y = -2 * r;
  int16_t x = 0;
  int16_t y = r;

  OLED_DrawPixel(x0  , y0+r, color);
  OLED_DrawPixel(x0  , y0-r, color);
  OLED_DrawPixel(x0+r, y0  , color);
  OLED_DrawPixel(x0-r, y0  , color);

  while (x<y)
  {
    if (f >= 0)
    {
      y--;
      ddF_y += 2;
      f += ddF_y;
    }
    x++;
    ddF_x += 2;
    f += ddF_x;

    OLED_DrawPixel(x0 + x, y0 + y, color);
    OLED_DrawPixel(x0 - x, y0 + y, color);
    OLED_DrawPixel(x0 + x, y0 - y, color);
    OLED_DrawPixel(x0 - x, y0 - y, color);
    OLED_DrawPixel(x0 + y, y0 + x, color);
    OLED_DrawPixel(x0 - y, y0 + x, color);
    OLED_DrawPixel(x0 + y, y0 - x, color);
    OLED_DrawPixel(x0 - y, y0 - x, color);
  }
}

/**
 * @brief Write character on OLED.
 *
 * Prints character on the OLED.
 *
 * @param value: Character to be written.
 * @param x: character starting position on x-axis. Valid values: 0..127
 * @param y: character starting position on x-axis. Valid values: 0..63
 */
void OLED_Write( int16_t x, int16_t y, char value )
{
  uint16_t font_idx = 0;
  uint16_t rowcnt = 0;
  uint16_t cnt = 0;
  uint8_t b;
  uint16_t temp = 0;

  int16_t cbyte, cx, cy;
  int16_t cbit;

  if( cfont.y_size%8 == 0)
  {
    font_idx = ((value-cfont.offset)*(cfont.x_size*(cfont.y_size/8))) + 4;
    for ( rowcnt=0; rowcnt<(cfont.y_size/8); rowcnt++ )
    {
      for( cnt=0; cnt<cfont.x_size; cnt++ )
      {
        temp = *(cfont.font + font_idx + cnt + (rowcnt*cfont.x_size));
        for ( b=0; b<8; b++ )
        {
          if ( temp & (1<<b) )
          {
            if (cfont.inverted == FALSE )
              OLED_DrawPixel(x+cnt, y+(rowcnt*8)+b, TRUE);
            else
              OLED_DrawPixel(x+cnt, y+(rowcnt*8)+b, FALSE);
          }
          else
          {
            if (cfont.inverted == FALSE )
              OLED_DrawPixel(x+cnt, y+(rowcnt*8)+b, FALSE);
            else
              OLED_DrawPixel(x+cnt, y+(rowcnt*8)+b, TRUE);
          }
        }
      }
    }
  }
  else
  {
    font_idx = ((value-cfont.offset)*((cfont.x_size*cfont.y_size)/8)) + 4;
    cbyte = *(cfont.font + font_idx);
    cbit = 7;
    for ( cx=0; cx<cfont.x_size; cx++ )
    {
      for ( cy=0; cy<cfont.y_size; cy++ )
      {
        if ( (cbyte & (1<<cbit)) != 0)
        {
          if ( cfont.inverted == FALSE )
            OLED_DrawPixel(x+cx, y+cy, TRUE);
          else
            OLED_DrawPixel(x+cx, y+cy, FALSE);
        }
        else
        {
          if ( cfont.inverted == FALSE )
            OLED_DrawPixel(x+cx, y+cy, FALSE);
          else
            OLED_DrawPixel(x+cx, y+cy, TRUE);
        }
        cbit--;
        if (cbit < 0)
        {
          cbit=7;
          font_idx++;
          cbyte= *(cfont.font+font_idx);
        }
      }
    }
  }
}

/**
 * @brief Write Text on OLED.
 *
 * Prints text on the OLED.
 *
 * @param *text: Pointer to the array of the text to be written.
 * @param x: character starting position on x-axis. Valid values: 0..127
 * @param y: character starting position on x-axis. Valid values: 0..63
 */
void OLED_Write_Text( int16_t x, int16_t y, char * format, ...)
{
	char text[OLED_LINE_LEN];
	va_list args;
	va_start(args, format);
	uint8_t length = vsnprintf(text, OLED_LINE_LEN, format, args);
  uint8_t cnt;
  
  if (x == RIGHT)
    x = 128-(length*cfont.x_size);
  if (x == CENTER)
    x = (128-(length*cfont.x_size))/2;

  for ( cnt=0; cnt<length; cnt++ )
    OLED_Write(x + (cnt*(cfont.x_size)), y, text[cnt] );
	va_end(args);
}

/**
 * @brief OLED Width
 *
 * @return Width
 */
static uint8_t width( void )
{
  return SSD1306_LCDWIDTH;
}

/**
 * @brief OLED Height
 *
 * @return Height
 */
static uint8_t height( void )
{
  return SSD1306_LCDHEIGHT;
}

/**
 * @brief Swap Number
 * 
 * Swap Number using call by reference method
 *
 * @param *a: First Number
 * @param *b: Second Number
 */
static void swap_num( uint16_t *a, uint16_t *b )
{
  uint16_t temp = *a;
  *a = *b;
  *b = temp;
}
