FMJ2000/EPR402/Results/explorer1.py

from matplotlib import markers
import numpy as np
import matplotlib.pyplot as plt

startPos = [[-0.64, 0.64],
	[-0.64, 0.64],
	[-0.64, 0.64],
	[-0.64, 0.64],
	[-0.64, 0.64],
	[-0.64, 0.64],
	[-0.64, 0.64],
	[-0.64, 0.64],
	[-0.64, 0.64]]
res = 0.08

def pos_plot(pos, exPos):
	plt.scatter(pos[0], pos[1], c='r', marker='.', s=400, label='bot')
	plt.scatter(exPos[0], exPos[1], c='b', marker='.', s=400, label='frontier')

def map_plot(map, index):
	title = str(index + 1) if index >= 0 else "summary"
	index = 0 if index < 0 else index
	for i in range(len(map)):
		for j in range(len(map[0])):
			plt.scatter(startPos[index][0] + i*res, startPos[index][1] - j*res, c=str(1/(1+np.exp(map[i][j]))))
	plt.title(f'Robot exploring environment - map {title}')
	plt.xlabel('x (m)')
	plt.ylabel('y (m)')
	plt.grid()

def visit_plot(map, index):
	for i in range(len(map)):
		for j in range(len(map[0])):
			for k in range(8):
				if ((map[i][j] >> k) & 0x1):
					plt.scatter(startPos[index][0] + i*res, startPos[index][1] - (8*j + k)*res, c='lightgreen')

def path_plot(path):
	print(path)

	plt.scatter(path[0][0], path[0][1], c='darkred', s=50, label='init pos', zorder=10)
	plt.scatter(path[-1][0], path[-1][1], c='orange', s=50, label='final pos', zorder=10)
	plt.plot(path[:,0], path[:,1], c='r', marker='.', markersize=20, label='path')

def paths():
	pos = [
		[0, 0],
		[0.16, -0.11],
		[0.45, 0.14],
		[0.45, -0.20],
		[0.36, -0.13],
		[0.26, -0.02],
		[0.25, 0.03],
		[0.09, 0.03]
	]

	exPos = [
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
[-128, 0, ],
[0, 3, ],
[0, 2, ],
[-128, 3, ],
[-128, 1, ],
[-64, 6, ],
[-64, 7, ],
[-64, 1, ],
[0, 0, ],
],
[[0, 0, ],
[0, 0, ],
[0, 0, ],
[0, 0, ],
[0, 0, ],
[0, 0, ],
[0, 0, ],
[-128, 0, ],
[0, 3, ],
[-128, 2, ],
[-128, 3, ],
[-128, 1, ],
[-64, 6, ],
[-64, 7, ],
[-64, 1, ],
[0, 0, ],
]
	]

	print(len(pos))
	print(len(maps))

	'''
	for i in range(len(maps)):
		plt.figure(figsize=(5,5))
		map_plot(maps[i], i)
		visit_plot(visited[i], i)
		pos_plot(pos[i], exPos[i])
		plt.legend(loc='lower left')
		plt.savefig(f'Figures/explorer{i}.png', format='png')

	#full = np.concatenate((maps[7], maps[11]))
	plt.figure(figsize=(5,5))
	map_plot(maps[-1], -1)
	visit_plot(visited[-1], -1)
	path_plot(np.array(pos))
	plt.legend(loc='lower left')
	plt.savefig(f'Figures/explorer_full.png', format='png')
	'''

	plt.figure(figsize=(5,5))

	

paths()
#plt.show()
