FMJ2000/EPR402/Results/planner5.py

from matplotlib import markers
import numpy as np
import matplotlib.pyplot as plt

startPos = [[-0.64, 0.64],
	[-0.64, 0.64],
	[-0.64, 0.64],
	[-0.64, 0.64],
	[-0.64, 0.64],
	[-0.64, 0.64],
	[-0.64, 0.64],
	[-0.64, 0.64],
	[0.64, 0.64],
	[0.64, 0.64],
	[0.64, 0.64],
	[0.64, 0.64]]
res = 0.08
mapSize = 1.28

def pos_plot(pos):
	plt.scatter(pos[0], pos[1], c='b', marker='.', s=400, label='bot', zorder=20)

def map_plot(map, index):
	title = str(index + 1) if index >= 0 else "summary"
	if index < 0:
		index = 0
	else:
		plt.xlim(startPos[index][0] - 0.04, startPos[index][0] + mapSize + 0.04)
		plt.ylim(startPos[index][1] - mapSize - 0.04, startPos[index][1] + 0.04)
	for i in range(len(map)):
		for j in range(len(map[0])):
			plt.scatter(startPos[index][0] + i*res, startPos[index][1] - j*res, c=str(1/(1+np.exp(map[i][j]))))
	plt.title(f'Robot planning path around obstacle - map {title}')
	plt.xlabel('x (m)')
	plt.ylabel('y (m)')

	plt.grid()

def path_plot(path, true=[]):
	plt.scatter(path[-1][0], path[-1][1], c='orange', s=50, label='est final pos', zorder=10)
	plt.plot(path[:,0], path[:,1], c='r', marker='.', markersize=20, label='estimated path')
	if len(true) > 0:
		plt.scatter(true[-1][0], true[-1][1], c='lightblue', s=50, label='real final pos', zorder=10)
		plt.plot(true[:,0], true[:,1], c='b', marker='.', markersize=20, label='real path')
	

def paths():
	pos = [
		[0, 0],
		[0, 0],
		[0.05, -0.00],
		[0.22, 0.11],
		[0.37, 0.24],
		[0.51, 0.27],
		[0.57, 0.27],
		[0.62, 0.27],
		[0.70, 0.19],
		[0.83, 0.15],
		[0.99, 0.02],
		[1.13, -0.00]
	]

	true = [
		[0, 0],
		[0, 0],
		[0.05, -0.00],
		[0.22, 0.11],
		[0.37, 0.24],
		[0.51, 0.27],
		[0.57, 0.27],
		[0.62, 0.27],
		[0.70, 0.24],
		[0.87, 0.21],
		[1.02, 0.17],
		[1.17, 0.15]
	]

	path = [
		[[0.15, 0.00],
		[0.30, 0.15],
		[0.45, 0.30],
		[0.60, 0.30]
		],
		[[0.15, 0.00],
		[0.30, 0.15],
		[0.45, 0.30],
		[0.60, 0.30]
		],
		[[0.30, 0.15],
		[0.45, 0.30],
		[0.60, 0.30]
		],
		[[0.45, 0.30],
		[0.60, 0.30]
		],
		[[0.60, 0.30]
		],
		[[0.66, 0.27],
		[0.81, 0.12],
		[0.96, -0.03],
		],
		[[0.72, 0.27],
		[0.87, 0.12],
		[1.02, -0.03],
		],
		[[0.77, 0.12],
		[0.92, 0.12],
		[1.07, -0.03],
		[1.22, -0.03]
		],
		[[0.92, 0.12],
		[1.07, -0.03],
		[1.22, -0.03]
		],
		[[1.07, -0.03],
		[1.22, -0.03]
		],
		[[1.22, -0.03]
		],
		[[1.13, -0.00],
		]
	]
	
	maps = [
		[[0.0, 0.0, 0.0, 0.0, 0.0, 0.0, 0.0, 0.0, 0.0, 0.0, 0.0, 0.0, 0.0, 0.0, 0.0, 0.0, ],
[0.0, 0.0, 0.0, 0.0, 0.0, 0.0, 0.0, 0.0, 0.0, 0.0, 0.0, 0.0, 0.0, 0.0, 0.0, 0.0, ],
[0.0, 0.0, 0.0, 0.0, 0.0, 0.0, 0.0, 0.0, 0.0, 0.0, 0.0, 0.0, 0.0, 0.0, 0.0, 0.0, ],
[0.0, 0.0, 0.0, 0.0, 0.0, 0.0, 0.0, 0.0, 0.0, 0.0, 0.0, 0.0, 0.0, 0.0, 0.0, 0.0, ],
[0.0, 0.0, 0.0, 0.0, 0.0, 0.0, 0.0, 0.0, 0.0, 0.0, 0.0, 0.0, 0.0, 0.0, 0.0, 0.0, ],
[0.0, 0.0, 0.0, 0.0, 0.0, 0.0, 0.0, 0.0, 0.0, 0.0, 0.0, 0.0, 0.0, 0.0, 0.0, 0.0, ],
[0.0, 0.0, 0.0, 0.0, 0.0, 0.0, 0.0, 0.0, 0.0, 0.0, 0.0, 0.0, 0.0, 0.0, 0.0, 0.0, ],
[0.0, 0.0, 0.0, 0.0, 0.0, 0.0, 0.0, 0.0, 0.0, 0.0, 0.0, 0.0, 0.0, 0.0, 0.0, 0.0, ],
[0.0, 0.0, 0.0, 0.0, 0.0, 0.0, 0.0, 0.0, 0.0, 0.0, 0.0, 0.0, 0.0, 0.0, 0.0, 0.0, ],
[0.0, 0.0, 0.0, 0.0, 0.0, 0.0, 0.0, 0.0, -16.9, 0.0, 0.0, 0.0, 0.0, 0.0, 0.0, 0.0, ],
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
[-0.8, -0.8, 0.0, -0.8, 3.3, 0.8, -2.8, -8.5, -13.4, -14.1, -13.4, -11.5, -11.0, -6.8, -6.8, -4.3, ],
[0.0, -0.8, -0.8, -0.8, -1.7, -4.2, -5.1, -8.5, -10.7, -10.9, -9.3, -11.9, -9.3, -8.1, -3.8, -0.5, ],
[0.0, 0.0, -0.8, -0.8, -2.5, -5.1, -5.1, -8.5, -10.2, -10.2, -7.6, -8.3, -6.9, -4.0, 1.3, 1.7, ],
[0.0, -0.1, 0.6, 1.4, -0.2, -4.6, -5.0, -7.6, -10.2, -6.8, -7.5, -2.8, -0.6, 4.3, 5.0, 3.5, ],
[0.0, 1.4, 1.4, 2.9, 4.0, 1.8, -0.0, -3.1, -4.6, -3.3, -0.6, 3.1, 6.7, 8.1, 5.5, 3.6, ],
[0.0, 1.5, 5.4, 4.2, 4.2, 4.2, 3.3, 2.3, 4.7, 4.3, 5.9, 5.5, 5.5, 7.9, 6.0, 1.7, ],
[0.0, 0.0, 0.0, 6.2, 4.2, 4.2, 3.3, 3.3, 4.7, 4.7, 4.2, 6.4, 4.4, 2.3, 0.0, 0.0, ],
]

	]

	print(len(pos))
	print(len(maps))
	
	'''
	for i in range(len(maps)):
		plt.figure(figsize=(5,5))
		map_plot(maps[i], i)
		path_plot(np.concatenate(([pos[i]], path[i])))
		pos_plot(pos[i])
		plt.legend(loc='lower left')
		plt.savefig(f'Figures/planner{i}.png', format='png')
	'''

	full = np.concatenate((maps[7], maps[11]))
	plt.figure(figsize=(10,5))
	map_plot(full, -1)
	path_plot(np.array(pos), np.array(true))
	plt.legend(loc='lower left')
	plt.savefig(f'Figures/planner_full.png', format='png')
	

paths()
#plt.show()
