FMJ2000/EPR402/Results/mapper.py

import numpy as np
import matplotlib.pyplot as plt

startPos = [[-0.64, 0.64], [0.64, 0.64]]
res = 0.08
mapSize = 1.28

'''
map = [[1.4, 0.3, -2.9, -6.8, -7.1, -7.0, -8.1, -6.7, -4.8, -7.0, -1.9, 1.0, 5.5, 3.9, 2.5, -31.3, ],
	[-2.2, -3.4, -1.7, -2.5, -3.4, -3.4, -4.2, -4.2, -6.2, -5.3, -3.6, -7.2, -5.3, 3.9, 2.5, -14.3, ],
	[0.0, -0.8, -1.7, -2.5, -3.4, -3.4, -4.2, -4.2, -4.2, -4.2, -6.1, -7.0, -7.2, -6.7, 1.1, 1.1, ],
	[0.0, -59.2, -43.4, 1.1, -2.0, -2.0, -4.2, -4.2, -4.2, -4.2, -5.1, -5.1, -4.2, -5.1, -1.8, -0.3, ],
	[-40.5, -5.6, 7.5, 1.1, -2.0, -2.0, -4.2, -4.2, -4.2, -3.4, -5.1, -4.2, -3.4, -3.4, -1.7, -1.7, ],
	[9.7, 9.7, 9.7, -4.0, -4.9, -4.8, -4.2, -4.2, -4.2, -3.7, -4.2, -3.4, -1.7, -1.7, -1.7, -1.7, ],
	[9.7, -0.7, -14.4, -8.9, -4.2, -4.2, -4.2, -4.2, -2.9, -2.9, 0.2, -0.3, -1.7, -1.7, -1.7, -0.8, ],
	[4.1, -13.3, -8.0, -5.9, -5.1, -4.2, -4.2, -7.1, -5.6, -1.9, 1.1, -12.7, -0.8, -0.8, -0.8, -0.8, ],
	[-6.8, -8.0, -5.1, -5.9, -5.1, -4.2, -4.2, -5.1, -40.8, -3.4, 3.3, 3.3, -16.0, -0.8, -0.8, -0.8, ],
	[-4.2, -4.2, -4.2, -4.2, -4.2, -4.2, -2.5, -35.9, -37.6, -39.9, 1.9, 1.9, -0.8, -0.8, -0.8, -0.8, ],
	[-3.4, -3.4, -4.2, -4.2, -4.2, -39.0, -51.2, -36.7, -36.7, -38.1, -35.9, -35.0, -0.8, -0.8, -0.8, -0.8, ],
	[-3.4, -3.4, -3.4, 54.8, -64.8, -39.0, -38.1, -38.1, -54.2, -40.9, -36.0, -35.9, -36.4, -36.4, -0.8, -0.8, ],
	[-4.2, -4.2, 52.4, 53.1, 53.1, -65.9, -114.7, -122.9, -131.2, -115.0, -35.4, -33.7, -51.6, -36.4, -36.4, -0.8, ],
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
	[0.0, 0.0, 0.0, 0.0, 0.0, 0.0, 0.0, 0.0, 0.0, 0.0, -0.8, -0.8, -0.8, -0.8, -0.8, -0.8, ],
	[0.0, 0.0, 0.0, 0.0, 0.0, 0.0, 0.0, 0.0, 0.0, 0.0, 0.0, -0.8, -0.8, -0.8, -0.8, -0.8, ],
	[0.0, 0.0, 0.0, 0.0, 0.0, 0.0, 0.0, 0.0, 0.0, 0.0, 0.0, -0.8, -0.8, -0.8, -0.8, -0.8, ],
	[0.0, 0.0, 0.0, 0.0, 0.0, 0.0, 0.0, 0.0, 0.0, 0.0, 0.0, -0.8, -0.8, -0.8, -0.8, -0.8, ],
	[0.0, 0.0, 0.0, 0.0, 0.0, 0.0, 0.0, 0.0, 0.0, 0.0, 0.0, -0.8, -0.8, -0.8, -0.8, -0.8, ],
	[0.0, 0.0, 0.0, 0.0, 0.0, 0.0, 0.0, 0.0, 0.0, 0.0, 0.0, -0.8, -0.8, -0.8, -0.8, -0.8, ],
	[0.0, 0.0, 0.0, 0.0, 0.0, 0.0, 0.0, 0.0, 0.0, 0.0, 0.0, -0.8, -0.8, -0.8, -0.8, -0.8, ],
	[0.0, 0.0, 0.0, 0.0, 0.0, 0.0, 0.0, 0.0, 0.0, 0.0, 0.0, -0.8, -0.8, -0.8, -0.8, -0.8, ],
	[0.0, 0.0, 0.0, 0.0, 0.0, 0.0, 0.0, 0.0, 0.0, 0.0, 0.0, -0.8, -0.8, -0.8, -0.8, -0.8, ],
	[0.0, 0.0, 0.0, 0.0, 0.0, 0.0, 0.0, 0.0, 0.0, 0.0, 0.0, -0.8, -0.8, -0.8, -0.8, -0.8, ],
	[0.0, 0.0, 0.0, 0.0, 0.0, 0.0, 0.0, 0.0, 0.0, 0.0, 0.0, 0.0, -0.8, -0.8, -0.8, -0.8, ],
	]
]

paths = [
	[[0., 0.],
	[0.40, -0.01],
	],
	[[0., 0.],
	[0.40, -0.01],
	[0.9, 0.01]
	]
]

def map_plot(map, index):
	for i in range(len(map)):
		for j in range(len(map[0])):
			plt.scatter(startPos[index][0] + i*res, startPos[index][1] - j*res, c=str(1/(1+np.exp(map[i][j]))))
	plt.title(f'Robot mapping small area - map {index}')
	plt.xlabel('x (m)')
	plt.ylabel('y (m)')
	#plt.xlim(startPos[index][0], startPos[index][0] + mapSize)
	#plt.xlim(startPos[index][1] - mapSize, startPos[index][1])
	plt.grid()

def path_plot(path):
	print(path)

	plt.scatter(path[0][0], path[0][1], c='darkred', s=50, label='init pos', zorder=10)
	plt.scatter(path[-1][0], path[-1][1], c='orange', s=50, label='final pos', zorder=10)
	plt.plot(path[:,0], path[:,1], c='r', marker='.', markersize=20, label='path')
	plt.legend(loc=4)

def main():
	for i in range(len(maps)):
		plt.figure(figsize=(10,5))
		map_plot(maps[i], i)
		path_plot(np.array(paths[i]))
	plt.show()

main()
