FMJ2000/EPR402/Results/planner3.py

from matplotlib import markers
import numpy as np
import matplotlib.pyplot as plt

startPos = [[-0.64, 0.64],
	[-0.64, 0.64],
	[-0.64, 0.64],
	[-0.64, 0.64],
	[-0.64, 0.64],
	[0.64, 0.64],
	[0.64, 0.64],
	[0.64, 0.64]]
res = 0.08

def map_plot(map, index):
	for i in range(len(map)):
		for j in range(len(map[0])):
			plt.scatter(startPos[index][0] + i*res, startPos[index][1] - j*res, c=str(1/(1+np.exp(map[i][j]))))
	plt.title(f'Robot planning path around obstacle - map {index + 1}')
	plt.xlabel('x (m)')
	plt.ylabel('y (m)')
	plt.grid()

def path_plot(path):
	print(path)

	plt.scatter(path[0][0], path[0][1], c='darkred', s=50, label='init pos', zorder=10)
	plt.scatter(path[-1][0], path[-1][1], c='orange', s=50, label='final pos', zorder=10)
	plt.plot(path[:,0], path[:,1], c='r', marker='.', markersize=20, label='path')
	plt.legend()

def paths():
	pos = [
		[0, 0],
		[0.14, -0.01],
		[0.38, -0.02],
		[0.53, -0.00],
		[0.67, 0.01],
		[0.81, 0.01],
		[0.96, -0.00],
		[1.10, 0.00]
	]

	path = [
		[[0.24, 0.00],
		[0.48, 0.00],
		[0.72, 0.00],
		[0.96, 0.00],
		],
		[[0.48, 0.00],
		[0.72, 0.00],
		[0.96, 0.00],
		],
		[[0.62, -0.02],
		[0.86, -0.02],
		[1.10, -0.02],
		],
		[[0.77, -0.00],
		[1.01, -0.00],
		],
		[[0.91, 0.01],
		],
		[[1.05, 0.01],
		],
		[[1.20, -0.00],
		],
		[[1.10, 0.00]]
	]
	
	maps = [
		[[0.0, 0.0, 0.0, 0.0, 0.0, 0.0, 0.0, 0.0, 0.0, 0.0, 0.0, 0.0, 0.0, 0.0, 0.0, 0.0, ],
		[0.0, 0.0, 0.0, 0.0, 0.0, 0.0, 0.0, 0.0, 0.0, 0.0, 0.0, 0.0, 0.0, 0.0, 0.0, 0.0, ],
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
		[0.0, 0.0, 0.0, 0.0, 0.0, 0.0, 0.0, 0.0, 0.0, 0.0, 0.0, 0.0, 0.0, 0.0, 0.0, 0.0, ],
		]
	]

	print(len(pos))
	print(len(path))
	print(len(maps))

	for i in range(len(path)):
		plt.figure(figsize=(10,5))
		map_plot(maps[i], i)
		path_plot(np.array(path[i]))
	

paths()
plt.show()
