FMJ2000/EPR402/Results/planner.py

from matplotlib import markers
import numpy as np
import matplotlib.pyplot as plt

startPos = [-0.64, 0.64]
res = 0.08

def small_map(map, index):
	'''
	small_map = [[0.0, 0.0, 0.0, 0.0, 0.0, 0.0, 0.0, 0.0, 0.0, 0.0, 0.0, 0.0, 0.0, 0.0, 0.0, 0.0, ],
[0.0, 0.0, 0.0, 0.0, 0.0, 0.0, 0.0, 0.0, 0.0, 0.0, 0.0, 0.0, 0.0, 0.0, 0.0, 0.0, ],
[0.0, 0.0, 0.0, 0.0, 0.0, 0.0, 0.0, 0.0, 0.0, 0.0, 0.0, 0.0, 0.0, 0.0, 0.0, 0.0, ],
[0.0, 0.0, 0.0, 0.0, 0.0, 0.0, 0.0, 0.0, 0.0, 0.0, 0.0, 0.0, 0.0, 0.0, 0.0, 0.0, ],
[0.0, 0.0, 0.0, 0.0, 0.0, 0.0, 0.0, 0.0, 0.0, 0.0, 0.0, 0.0, 0.0, 0.0, 0.0, 0.0, ],
[0.0, 0.0, 0.0, 0.0, 0.0, 0.0, 0.0, 0.0, 0.0, 0.0, 0.0, 0.0, 0.0, 0.0, 0.0, 0.0, ],
[0.0, 0.0, 0.0, 0.0, 0.0, 0.0, 0.0, 0.0, 0.0, 0.0, 0.0, 0.0, 0.0, 0.0, 0.0, 0.0, ],
[0.0, 0.0, 0.0, 0.0, 0.0, 0.0, 0.0, 0.0, 0.0, 0.0, 0.0, 0.0, 0.0, 0.0, 0.0, 0.0, ],
[0.0, 0.0, 0.0, 0.0, 0.0, 0.0, 0.0, 0.0, -5.1, 0.0, 0.0, 0.0, 0.0, 0.0, 0.0, 0.0, ],
[0.0, 0.0, 0.0, 0.0, 0.0, 0.0, 0.0, -5.1, -5.1, -5.1, 0.0, 0.0, 0.0, 0.0, 0.0, 0.0, ],
[0.0, 0.0, 0.0, 0.0, 0.0, -5.1, -5.1, -5.1, -5.1, -5.1, -5.1, -5.1, 0.0, 0.0, 0.0, 0.0, ],
[0.0, 0.0, 0.0, -5.1, -5.1, -5.1, -5.1, -5.1, -5.1, -5.1, -5.1, -5.1, -5.1, -5.1, 0.0, 0.0, ],
[0.0, 0.0, -5.1, -5.1, -5.1, -5.1, -5.1, -5.1, -5.1, -5.1, -5.1, -5.1, -5.1, -14.8, 6.1, 0.0, ],
[-5.1, -5.1, -5.1, -5.1, -5.1, -5.1, -5.1, -5.1, -5.1, -5.1, -5.1, -5.1, -14.8, -3.6, 8.3, 8.3, ],
[-5.1, -5.1, -5.1, -5.1, -5.1, -5.1, -11.1, -14.4, -15.5, -14.4, -11.1, -10.7, 6.1, 8.3, 8.3, -69.5, ],
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
		[0.0, 0.0, 0.0, 0.0, 0.0, 0.0, 0.0, 0.0, 0.0, 0.0, 0.0, 0.0, 0.0, 0.0, 0.0, 0.0, ],
		[0.0, 0.0, 0.0, 0.0, 0.0, 0.0, 0.0, 0.0, 0.0, 0.0, 0.0, 0.0, 0.0, 0.0, 0.0, 0.0, ],
		]
	]

	for i in range(len(path)):
		plt.figure()
		small_map(maps[i], i)
		path_plot(np.array(path[i]))

paths()
plt.show()
