FMJ2000/EPR402/Results/planner2.py

from matplotlib import markers
import numpy as np
import matplotlib.pyplot as plt

startPos = [[-0.64, 0.64],
	[-0.64, 0.64],
	[-0.64, 0.64],
	[0.64, 0.64],
	[0.64, 0.64]]
res = 0.08

def small_map(map, index):
	for i in range(32):
		for j in range(16):
			plt.scatter(startPos[index][0] + i*res, startPos[index][1] - j*res, c=str(1/(1+np.exp(map[i][j]))))
	plt.title(f'Robot planning path around obstacle - map {index}')
	plt.xlabel('x (m)')
	plt.ylabel('y (m)')
	plt.grid()

def path_plot(path):
	print(path)

	plt.scatter(path[0][0], path[0][1], c='darkred', s=50, label='init pos', zorder=10)
	plt.scatter(path[-1][0], path[-1][1], c='orange', s=50, label='final pos', zorder=10)
	plt.plot(path[:,0], path[:,1], c='r', marker='.', markersize=20, label='path')
	plt.legend()

def paths():
	path = [
		[[0.24, 0.00],
		[0.48, 0.24],
		[0.72, 0.24],
		[0.96, 0.00],
		[1.20, 0.00],
		],
		[[0.48, 0.24],
		[0.72, 0.24],
		[0.96, 0.00],
		[1.20, 0.00],
		],
		[[0.65, -0.07],
		[0.89, -0.31],
		[1.13, -0.07],
		],
		[[0.84, -0.23],
		[1.08, 0.01],
		],
		[[1.08, 0.01],
		],
	]
	maps = [
		[[0.0, 0.0, 0.0, 0.0, 0.0, 0.0, 0.0, 0.0, 0.0, 0.0, 0.0, 0.0, 0.0, 0.0, 0.0, 0.0, ],
		[0.0, 0.0, 0.0, 0.0, 0.0, 0.0, 0.0, 0.0, 0.0, 0.0, 0.0, 0.0, 0.0, 0.0, 0.0, 0.0, ],
		[0.0, 0.0, 0.0, 0.0, 0.0, 0.0, 0.0, 0.0, 0.0, 0.0, 0.0, 0.0, 0.0, 0.0, 0.0, 0.0, ],
		[0.0, 0.0, 0.0, 0.0, 0.0, 0.0, 0.0, 0.0, 0.0, 0.0, 0.0, 0.0, 0.0, 0.0, 0.0, 0.0, ],
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
		[0.0, 0.0, 0.0, 0.0, 0.0, 0.0, 0.0, 0.0, 0.0, 0.0, 0.0, 0.0, 0.0, 0.0, 0.0, 0.0, ],
		[0.0, 0.0, 0.0, 0.0, 0.0, 0.0, 0.0, 0.0, 0.0, 0.0, 0.0, 0.0, 0.0, 0.0, 0.0, 0.0, ],
		]
	]

	for i in range(len(path)):
		plt.figure()
		small_map(maps[i], i)
		path_plot(np.array(path[i]))

paths()
plt.show()
