FMJ2000/EPR402/mplab/Master.X/master.h

#ifndef MASTER_H
#define MASTER_H

#include <xc.h>
#include <proc/p32mx270f256b.h>
#include <sys/attribs.h>
#include <sys/kmem.h>
#include <stdlib.h>
#include <math.h>
#include <string.h>
#include <stdio.h>

#include "periph.h"
#include "imu.h"
#include "oled.h"
#include "bot.h"
#include "aux.h"

/* definitions */
#define SYSCLK 64000000l
#define PBCLK 32000000l
#define FREQ 20
#define DT 0.05
#define US_TRIG_T 640           // ultrasonic trigger
#define US_SENSORS 3
#define SENSOR_OFFSET 40. * M_PI / 180.  // angle offset between two sensors
#define SENSOR_ANGLE 12. * M_PI / 180.
#define MAX_US_DIST 0.6
#define INIT_T 12
#define EXEC_T 142
#define VAC_T 20

/* static global variables/constants */
static struct Bot * bot;
static float sensorModifier[US_SENSORS][US_SENSORS] = { 
    {3, 1, -3},
    {0.5, 1, 0.5},
    {-3, 1, 3}
};

void SYS_Unlock();
void SYS_Lock();

#endif
