FMJ2000/EPR402/mplab/Master.X/aux.h

#ifndef _AUX_H
#define _AUX_H

#include "master.h"
#include "bot.h"

/* helper functions */
float getAngle(float pos1[3], float pos2[2]);
float normAngle(float x);
float getDistance(float pos1[2], float pos2[2]);
void distanceToPos(float result[][2], float botPos[3], float sensorOffsets[3], float * distances);
void delay(long long us);

// Matrix equations
void Mat_T(uint8_t rows, uint8_t cols, float result[cols][rows], float mat[rows][cols]);
void Mat_Add(uint8_t rows, uint8_t cols, float result[rows][cols], float mat1[rows][cols], float mat2[rows][cols]);
void Mat_Sub(uint8_t rows, uint8_t cols, float result[rows][cols], float mat1[rows][cols], float mat2[rows][cols]);
void Mat_Mul(uint8_t rows, uint8_t cols, uint8_t add, float result[rows][cols], float mat1[rows][add], float mat2[add][cols]);
void Mat_Inv(uint8_t rows, float result[rows][rows], float mat[rows][rows]);
float Mat_Det(uint8_t rows, float mat[rows][rows]);

void norm(uint8_t len, float x[len]);
void cholesky(uint8_t rows, float L[rows][rows], float A[rows][rows]);


#endif
