FMJ2000/EPR402/(commit log)

2021-07-04 ultrasonic code v1
2021-08-24 New work
    [hendrik-B_Cu.gbr, hendrik-B_Mask.gbr, hendrik-B_Paste.gbr, hendrik-B_SilkS.gbr, hendrik-Edge_Cuts.gbr, hendrik-F_Cu.gbr, hendrik-F_Mask.gbr, hendrik-F_Paste.gbr]
2021-08-24 PCB complete
    [hendrik.kicad_pcb, hendrik.sch]
2021-09-24 mplab init
    [hendrik-B_Cu.gbr, hendrik-B_Mask.gbr, hendrik-B_Paste.gbr, hendrik-B_SilkS.gbr, hendrik-Edge_Cuts.gbr, hendrik-F_Cu.gbr, hendrik-F_Mask.gbr, hendrik-F_Paste.gbr]
2021-09-25 I2C working
2021-09-27 i2c slave works
2021-10-07 pid controller
2021-10-14 mapping and pid simulations
    [data.csv]
2021-11-18 pid working almost
2021-11-19 pid still not working, but almost
    [aux.c, aux.h, bot.c, bot.h, k.py, map.c, master.c, odo.py]
